tgatomic/DirtyDawg/Dokument/Funktioner.odt

Funktioner

1284P – Linkuras mätare

Funktionsnamn | Beskrivning
System_Init | Ska inititera portarna, watchdog, ADC och sedan kalla funktioner BT_Init, ECG_Init, UART_Init, LIS3DH_Init.
BT_Init | Startar BT121, sätter baudrate, samt initierar den i CLASSIC läge och gör den detekteringsbar och redo att parkopplas.
UART_Init | Sätter baudraten för kommunikation mellan MCU och BT121 samt sätter register för UDR1 och UDR0 (Som är för skicka och ta emot data)
LIS3DH_Init | Intitierar accelerometer
No_Connection | Väntar här till det att bilen har kopplat upp sig till BT121 - modulen
Connected | Skickar accelerometer- och pulsdata till bilen och tar emot distansdata från bilen och skickar det via UART till ATMega8 samt registrerar eventuella knapptryck.

ATMega8-16PU – LCD MCU

Funktionsnamn | Beskrivning
System_Init | Initiera portarna, watchdog, knappar samt UART och eller I2C.
LCD_Init | Skriver ut ett ”Booting” meddelande på skärmen vid power on
Button_Press | Registrerar knapptryck och skickar till 1284p
Dist_Print | Tar emot distansdata från 1284p och skriver ut på LCD

Mega328p – Master bil

Funktionsnamn | Beskrivning
System_Init | Ska inititera portarna, watchdog, ADC och sedan kalla funktioner BT_Init, UART_Init och I2C_Init. Sätter ljusnivåer.
UART_Init | Initierar UART
BT_Init | Intitierar och sätter baudrate för BT
I2C_Init | Intitierar MCU som master och registrerar adressen för ATTiny85
BT_Connect | Väntar på att BT121 blir tillgänglig och kopplar upp när den är tillgänglig
Connected | Läser data från slave i I2C bussen och skickar det till BT121. Läser data från BT121 och kör enligt datan. Går tillbaka till BT_Connect vid förlorad kontakt med BT121
INT_Crash | Stannar bilen om vi får en interrupt från ATTiny85.
Lowrider_Mode | Startar lowrider mode...
Sense_Light | Tänder lamporna på bilen om det är mörkt.

ATTiny85– Slave bil

Funktionsnamn | Beskrivning
System_Init | Ska initiera portarna, watchdog, ADC och sedan kalla funktionen I2C_Init.
IR_Init | Kollar så att IR lamporna och sensorerna är igång genom att kolla sensorinput
I2C_Init | Initierar I2C som slave
INT_Crash | Skickar en interrupt till Mega328P om objekt är för nära
Send_Dist | Skickar distansdata genom I2C
