tgatomic/DirtyDawg/Dokument/Kravlista.odt

Uppgift

Göra en bil som kan detektera avstånd till objekt och skicka den datan vidare till vår kontrollenhet. Genom att få distans till objekt hoppas vi kunna köra bilen utan att vara i samma rum. Bilens hastighet styras av pulsen och styrningen genom vinkeln på kontrollen.

Kravlista för bilen

Index | Historik | Uppgift | Prio
1 | Orginal | Bilen ska ha två MCUs. En som tar hand om sensorer och en som sköter motor och BT-kommunikation | 1
2 | Orginal | Bilen ska ha en IR-sensor som mäter avstånd till objekt. | 1
3 | Orginal | IR Sensorn ska styras med en mikrokontroller och skicka data via I2C bussen till Master. | 1
4 | Orginal | Bilen ska kunna köra framåt, bakåt, höger och vänster | 1
5 | Orginal | Bilen ska kunna skicka distansdata till vår kontroll | 1
6 | Orginal | Bilen ska kunna tända röda lampor när den bromsar eller stannar | 2
7 | Orginal | Bilens lampor ska tändas när det blir mörkt | 2
8 | Orginal | De två MCU:erna på bilen ska kommunicera med varandra genom I2C. | 1
9 | Orginal | Bilen ska kunna tända RGB stripes som sitter under bilen | 2
10 | Orginal | Bilen ska kunna bli en ”low rider” | 3
11 | Orginal | Bilen ska kunna ta emot data från kontrollen via bluetooth | 1
12 | Orginal | Bilen ska dras av batterier | 1
13 | Orginal | Vi ska kunna tuta | 2
14 | Orginal | Bilens hastighet ska kunna ändras baserat på användarens puls | 1

Kravlista för handkontroll

Index | Historik | Uppgift | Prio
15 | Orginal | Kontrollen ska kunna läsa puls och lutningen på kontrollen.Det ska sedan via BT till bilen. | 1
16 | Orginal | Distansdata ska skrivas ut på en display | 1
17 | Orginal | Kontrollen ska kunna drivas med batteri | 1
18 | Orginal | Kontrollen ska ha knapp för att kunna slå på och av lampor samt bil | 1
19 | Orginal | Kontrollen ska ha knapp för tuta | 2
20 | Orginal | Bilen ska ha en ”init low rider” knapp | 3
21 | Orginal | Vara bärbar | 1

Ansvarsområden

Linkuras modul (1284p)

Janne

MCU ( Atmega8-16PU) i handkontroll

Andreas

Distanssensor + MCU (ATTINY84) i bil

Yasmine

Master MCU (UNO) i bil

Christoffer
