tgatomic/DirtyDawg/KiCad - wController/NPN Boost.PNG

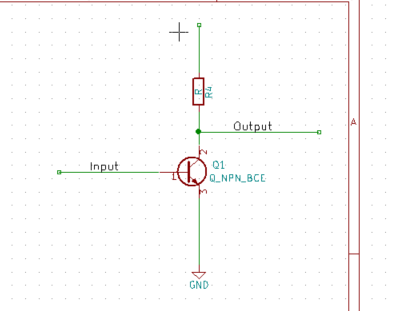
KiCad - wController/NPN Boost.PNG
