tgatomic/DirtyDawg/KiCad - wController/OP.PNG

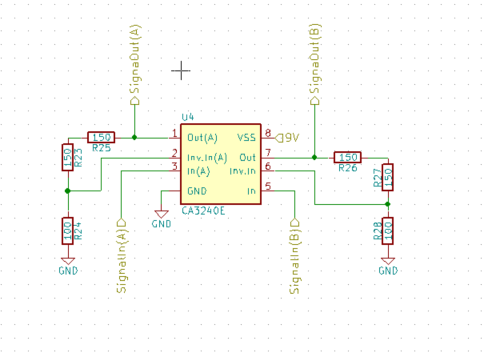
KiCad - wController/OP.PNG
