tgatomic/DirtyDawg/Dokument/Kalkyl.ods

Artikel | Bil/handkontroll | St | Pris | Total | Finns redan | Länk
Linkura mätare | Handkontroll | 1 | 0 |  | X | Linkura bjuder
Strömkälla | Handkontroll | 1 |  | 0
LCD 16x2 | Handkontroll | 2 | 0 | 0 | X | Finns på skolan
BlueSmirf | Bil | 1 | 0 | 0 | X | Finns på skolan
Atmega8-16PU | Handkontroll | 1 | 31 | 31 |  | http://www.electrokit.com/atmega328pu.49179
Strömbrytare | Handkontroll | 1 |  | 20 |  | http://www.kjell.com/se/sortiment/el-verktyg/elektronik/rc-tillbehor/tillbehor-servo-mottagare/1-polig-strombrytare-till-till-100-ma-p67396
Strömbrytare | Handkontroll | 2 | 0 | 24 | X | http://www.kjell.com/se/sortiment/el-verktyg/elektronik/elektromekanik/strombrytare/tryckstrombrytare/tryckstrombrytare-fran-(till)-bla-p36023
Mega328P | Bil | 1 | 39 | 39 |  | http://www.lawicel-shop.se/prod/Mega328P-ArduinoGenuino-UNO-BL_787537/Kretsar_8899/SWE/SEK
ATTiny84 | Bil | 1 | 34 | 34 | X | http://www.lawicel-shop.se/prod/Atmel-AVR-Tiny84---DIP14_977240/Kretsar_8899/SWE/SEK
IR emitter | Bil | 1 | 20 | 20 |  | http://www.kjell.com/se/sortiment/el-verktyg/elektronik/optokomponenter/ir-dioder-fototransistorer/ir-dioder-5-mm-10-pack-p89281
IR reciever | Bil | 4 | 15 | 60 |  | http://www.kjell.com/se/sortiment/el-verktyg/elektronik/optokomponenter/ir-dioder-fototransistorer/fototransistor-5-mm-p90042
Diod | Bil | 4 | 0 | 0 | X | Finns på skolan
H-brygga | Bil | 1 | 21 | 21 | X | http://www.electrokit.com/sn754410ne.49232?sort=price_asc
Strömbrytare | Handkontroll | 1 |  | 20 |  | http://www.kjell.com/se/sortiment/el-verktyg/elektronik/rc-tillbehor/tillbehor-servo-mottagare/1-polig-strombrytare-till-till-100-ma-p67396
RGB | Bil | 1 | 75 | 75 |  | https://www.m.nu/neopixel-stick-ws2812-5050-with-integrated-drivers-p-1081.html
Programmerare | Övrigt | 1 | 129 | 129 |  | http://www.lawicel-shop.se/prod/Pololu-USB-AVR-Programmer-v2_1089820/Pololu_55653/SWE/SEK
Experimentkort | Övrgt | 1 | 59 | 59 |  | http://www.kjell.com/se/sortiment/el-verktyg/elektronik/monsterkort/experimentkort/experimentkort-fr4-100x160-mm-3-lankar-p89417
 |  |  |  | 473 | Med | programerare
 |  |  |  | 344 | Utan | Programerare
