tgatomic/DirtyDawg/Dokument/Testplan.odt

Testplan

Bilen

Index | Testförfarande | Testad
2 | Vi placerar ett objekt på 30 cm och 60 cm och verifierar att vi får rätt distans utskrivet t.ex. genom UART till dator
3 | Vi placerar ett objekt på valfritt avstånd och säkerställer att distansen skickas till master MCU
4 | Vi skriver kod som automatiskt kör en test som ska göra att bilen först kör fram, sen bakåt, höger fram och vänster fram
5 | Vi sätter Master MCU att skicka förangivna värden över BT till vår handkontroll och verifierar att det är samma värden vi tar emot.
6 | Vi skriver en kodsnutt som kör bilen framåt och sedan backar och verifierar att den röda lampan lyser samt att den röda lampan lyser när bilen står stilla
7 | Vi sätter bilen i ett mörkt rum och verifierar att lamporna tänds
8 | Vi testar att skicka en förangiven data från slave till master och verifierar att det är samma data som vi tar emot
9 | Vi skriver en liten kod som tänder RGB lampan
10 | Vi skriver en liten kod som kan sätta bilen i ”low rider”-mode och kollar så att det fungerar
11 | Vi skickar förangiven data från kontrollen till bilen och verifierar att vi får samma till master MCU
12 | Vi låter bilen vara igång en liten stund med batterier och dubbelkollar så att det inte tar slut direkt
13 | Vi gör en kod som slår igång tutan och lyssnar noga
14 | Vi skriver en kod som simulerar puls på Master MCU och kollar om motorns hastighet ändras

Kontrollen

Index | Testförfarande | Testad
15.1 | Vi gör en kod som känner efter puls och kollar det via UART. Vi gör samma med accelerometern
15.2 | När 15.1 är klar, skickar vi datan till MCU Master i bilen och verifierar att vi tagit emot samma data
16.1 | Vi gör en kod som simulerar att vi tagit emot distansdata och skriver ut på LCD displayen
16.2 | När 16.2 är avklarad, testar vi att ta emot distansdata från bilen och verifierar att det är rätt data som tagits emot
17 | Vi kontrollerar att kontrollen kan drivas med ett batteri i minst 5 minuter
18 | Vi kontrollerar att vi kan tända och släcka lamporna med knappar alternativt en snutt kod
