tgatomic/DirtyDawg/(list of files, drawings)

Other design files:
KiCad - wController/Project.dsn
KiCad/Project2.dsn
KiCad/Project3.dsn
KiCad/Project4.dsn
KiCad/Project5.dsn
KiCad/Project6.dsn
KiCad/Project7.dsn
KiCad/Project8.dsn
KiCad/Project9.dsn
KiCad/Project10.dsn
KiCad/Project11.dsn
KiCad/Project.dsn
