tgatomic/DirtyDawg/KiCad/Project.kicad_pcb

## KiCad design KiCad/Project.kicad_pcb (2016-06-13)

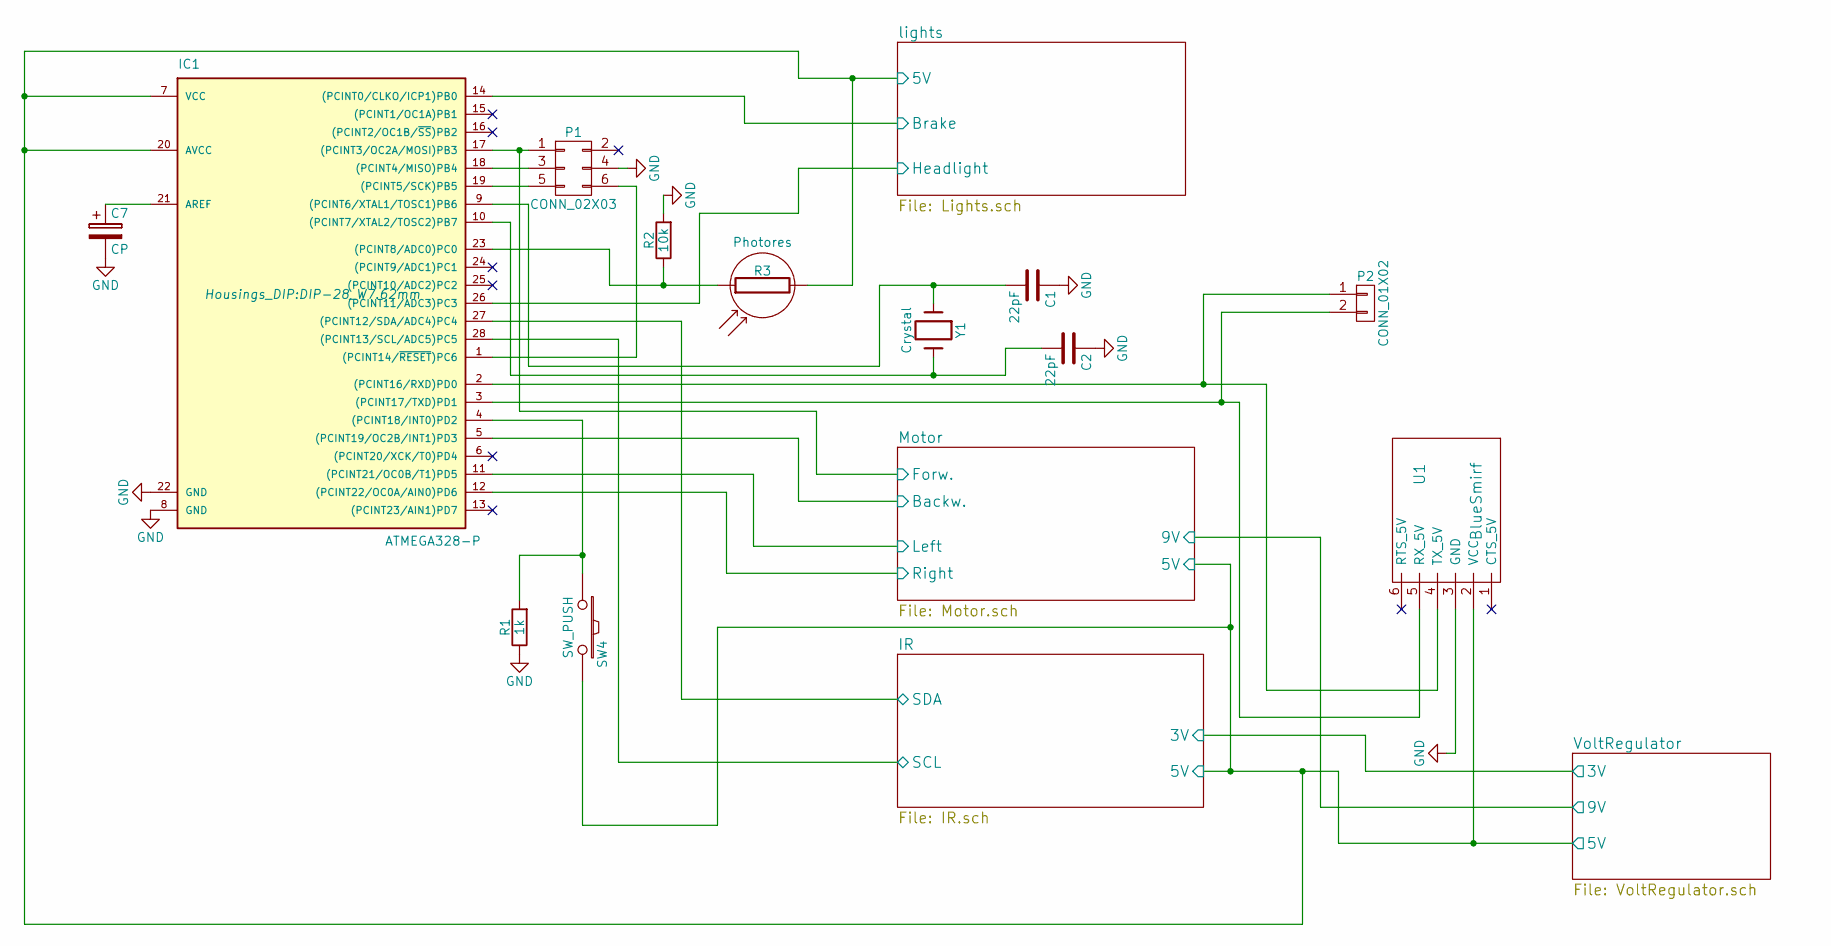
[picture p3: schematic Project.sch]

Parts:
C1, C2: 22pF; C_Disc_D3_P2.5
C7: CP; C_Radial_D5_L6_P2.5
IC1: ATMEGA328-P; DIP-28_W7.62mm
P1: CONN_02X03; Pin_Header_Straight_2x03
P2: CONN_01X02; Pin_Header_Straight_1x02
R1: 1k; Resistor_Vertical_RM5mm
R2: 10k; Resistor_Vertical_RM5mm
R3: Photores; SolderWirePad1mmmodified
SW4: SW_PUSH; SolderWirePad1mmmodified
U1: BlueSmirf; Pin_Header_Straight_1x06_Pitch2.00mm
Y1: Crystal; Crystal_HC52-U_Vertical

Connections:
/IR/5V: IC1.7 (VCC), IC1.20 (AVCC), R3.2, SW4.2, U1.2 (VCC); also elsewhere on the board
/IR/SCL: IC1.28 ((PCINT13/SCL/ADC5)PC5); also elsewhere on the board
/IR/SDA: IC1.27 ((PCINT12/SDA/ADC4)PC4); also elsewhere on the board
/Motor/Backw.: IC1.5 ((PCINT19/OC2B/INT1)PD3); also elsewhere on the board
/Motor/Forw.: IC1.17 ((PCINT3/OC2A/MOSI)PB3), P1.1; also elsewhere on the board
/Motor/Left: IC1.11 ((PCINT21/OC0B/T1)PD5); also elsewhere on the board
/Motor/Right: IC1.12 ((PCINT22/OC0A/AIN0)PD6); also elsewhere on the board
/lights/Brake: IC1.14 ((PCINT0/CLKO/ICP1)PB0); also elsewhere on the board
/lights/Headlight: IC1.26 ((PCINT11/ADC3)PC3); also elsewhere on the board
GND: C1.1, C2.1, C7.2, IC1.8 (GND), IC1.22 (GND), P1.4, R1.1, R2.2, U1.3 (GND); also elsewhere on the board
unnamed: C1.2, IC1.9 ((PCINT6/XTAL1/TOSC1)PB6), Y1.1
unnamed: C2.2, IC1.10 ((PCINT7/XTAL2/TOSC2)PB7), Y1.2
unnamed: C7.1, IC1.21 (AREF)
unnamed: IC1.1 ((PCINT14/~RESET~)PC6), P1.6
unnamed: IC1.2 ((PCINT16/RXD)PD0), P2.1, U1.4 (TX_5V)
unnamed: IC1.3 ((PCINT17/TXD)PD1), P2.2, U1.5 (RX_5V)
unnamed: IC1.4 ((PCINT18/INT0)PD2), R1.2, SW4.1
unnamed: IC1.18 ((PCINT4/MISO)PB4), P1.3
unnamed: IC1.19 ((PCINT5/SCK)PB5), P1.5
unnamed: IC1.23 ((PCINT8/ADC0)PC0), R2.1, R3.1

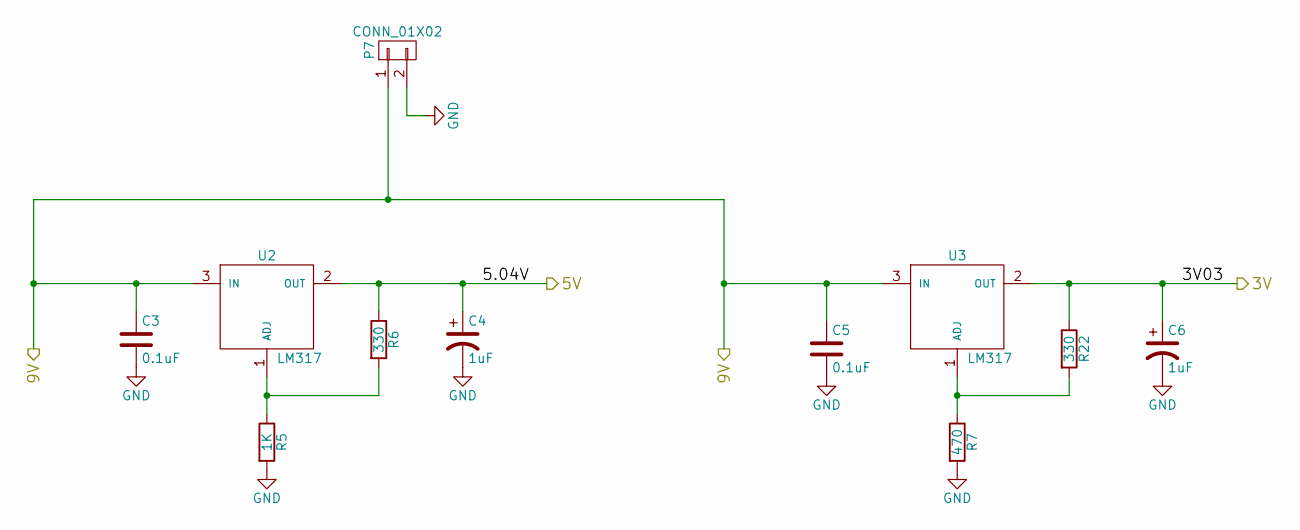
[picture p4: schematic VoltRegulator.sch]

Parts:
C3, C5: 0.1uF; C_Disc_D3_P2.5
C4, C6: 1uF; C_Radial_D5_L6_P2.5
P7: CONN_01X02; Pin_Header_Straight_1x02
R5: 1K; Resistor_Vertical_RM5mm
R6, R22: 330; Resistor_Vertical_RM5mm
R7: 470; Resistor_Vertical_RM5mm
U2, U3: LM317; TO-220_Neutral123_Vertical

Connections:
/IR/3V: C6.1, R22.1, U3.2 (OUT); also elsewhere on the board
/IR/5V: C4.1, R6.1, U2.2 (OUT); also elsewhere on the board
/Motor/9V: C3.1, C5.1, P7.1, U2.3 (IN), U3.3 (IN); also elsewhere on the board
GND: C3.2, C4.2, C5.2, C6.2, P7.2, R5.2, R7.2; also elsewhere on the board
unnamed: R5.1, R6.2, U2.1 (ADJ)
unnamed: R7.1, R22.2, U3.1 (ADJ)

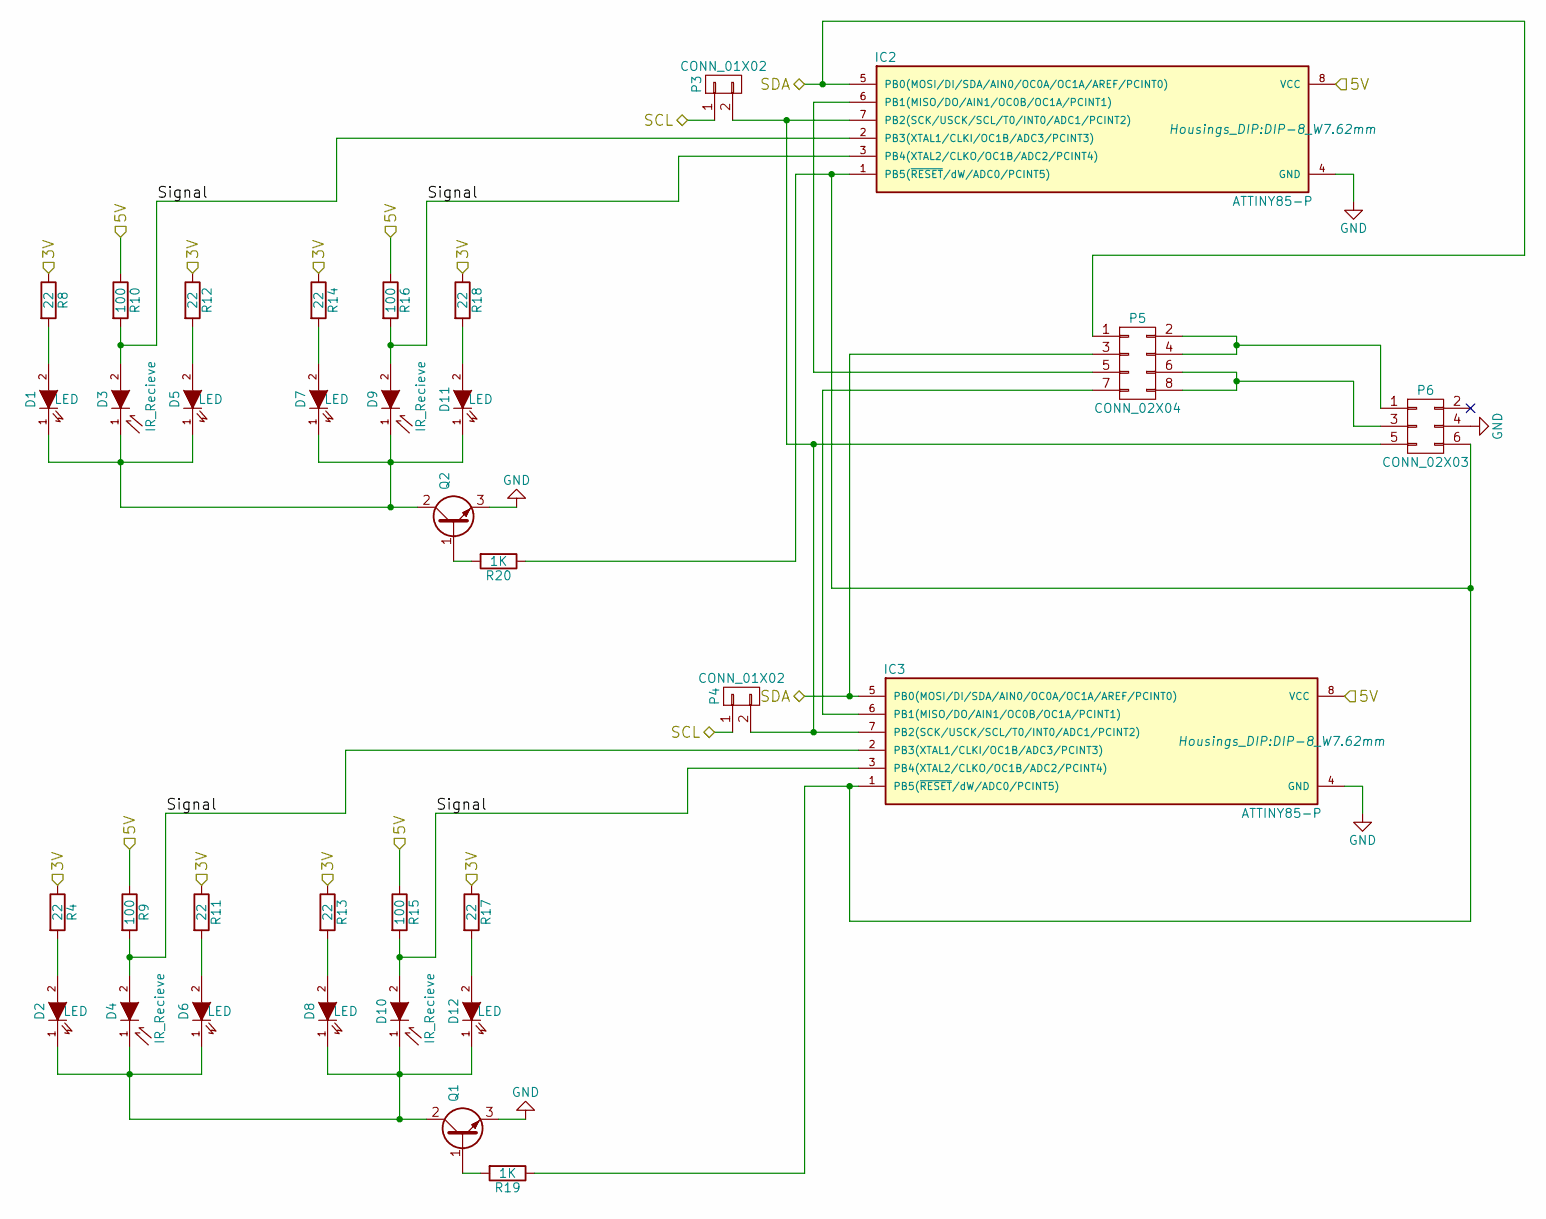
[picture p5: schematic IR.sch]

Parts:
D1, D2, D5, D6, D7, D8, D11, D12: LED; SolderWirePad1mmmodified
D3, D4, D9, D10: IR_Recieve; SolderWirePad1mmmodified
IC2, IC3: ATTINY85-P; DIP-8_W7.62mm
P3, P4: CONN_01X02; Pin_Header_Straight_2x01
P5: CONN_02X04; Pin_Header_Straight_2x04
P6: CONN_02X03; Pin_Header_Straight_2x03
Q1, Q2: Q_NPN_BCE; TO-92_Inline_Narrow_Oval
R4, R8, R11, R12, R13, R14, R17, R18: 22; Resistor_Vertical_RM5mm
R9, R10, R15, R16: 100; Resistor_Vertical_RM5mm
R19, R20: 1K; Resistor_Vertical_RM5mm

Connections:
/IR/3V: R4.1, R8.1, R11.1, R12.1, R13.1, R14.1, R17.1, R18.1; also elsewhere on the board
/IR/5V: IC2.8 (VCC), IC3.8 (VCC), R9.1, R10.1, R15.1, R16.1; also elsewhere on the board
/IR/SCL: P3.1, P4.1; also elsewhere on the board
/IR/SDA: IC2.5 (PB0(MOSI/DI/SDA/AIN0/OC0A/OC1A/AREF/PCI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), IC3.5 (PB0(MOSI/DI/SDA/AIN0/OC0A/OC1A/AREF/PCI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), P5.1, P5.3; also elsewhere on the board
/IR/Signal: D3.2 (A), D4.2 (A), D9.2 (A), D10.2 (A), IC2.2 (PB3(XTAL1/CLKI/OC1B/ADC3/PCINT3)), IC2.3 (PB4(XTAL2/CLKO/OC1B/ADC2/PCINT4)), IC3.2 (PB3(XTAL1/CLKI/OC1B/ADC3/PCINT3)), IC3.3 (PB4(XTAL2/CLKO/OC1B/ADC2/PCINT4)), R9.2, R10.2, R15.2, R16.2
GND: IC2.4 (GND), IC3.4 (GND), P6.4, Q1.3 (E), Q2.3 (E); also elsewhere on the board
unnamed: D1.1 (K), D3.1 (K), D5.1 (K), D7.1 (K), D9.1 (K), D11.1 (K), Q2.2 (C)
unnamed: D1.2 (A), R8.2
unnamed: D2.2 (A), R4.2
unnamed: D5.2 (A), R12.2
unnamed: D6.2 (A), R11.2
unnamed: D7.2 (A), R14.2
unnamed: D8.2 (A), R13.2
unnamed: D2.1 (K), D4.1 (K), D6.1 (K), D8.1 (K), D10.1 (K), D12.1 (K), Q1.2 (C)
unnamed: D11.2 (A), R18.2
unnamed: D12.2 (A), R17.2
unnamed: IC2.1 (PB5(~RESET~/dW/ADC0/PCINT5)), IC3.1 (PB5(~RESET~/dW/ADC0/PCINT5)), P6.6, R19.1, R20.1
unnamed: IC2.6 (PB1(MISO/DO/AIN1/OC0B/OC1A/PCINT1)), P5.5
unnamed: IC2.7 (PB2(SCK/USCK/SCL/T0/INT0/ADC1/PCINT2)), IC3.7 (PB2(SCK/USCK/SCL/T0/INT0/ADC1/PCINT2)), P3.2, P4.2, P6.5
unnamed: IC3.6 (PB1(MISO/DO/AIN1/OC0B/OC1A/PCINT1)), P5.7
unnamed: P5.2, P5.4, P6.1
unnamed: P5.6, P5.8, P6.3
unnamed: Q1.1 (B), R19.2
unnamed: Q2.1 (B), R20.2

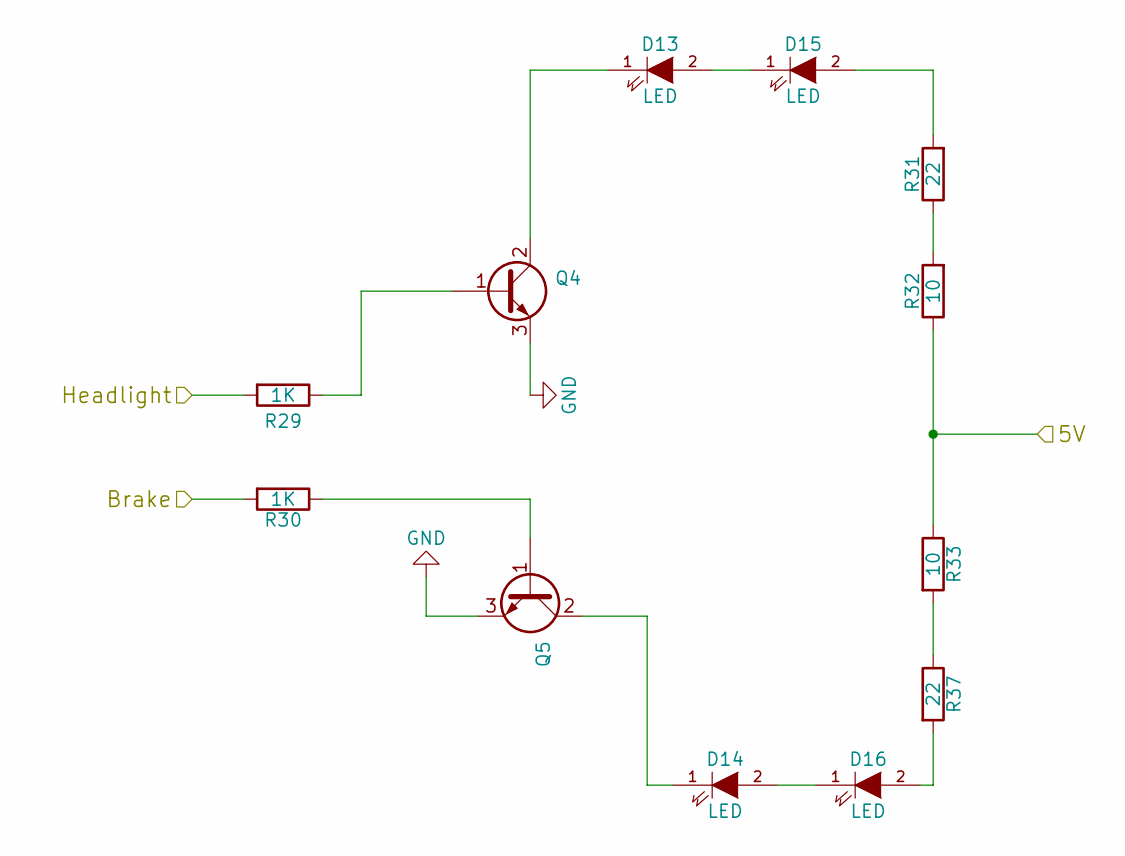
[picture p6: schematic Lights.sch]

Parts:
D13, D14, D15, D16: LED; SolderWirePad1mmmodified
Q4: Q_NPN_BCE; TO-92_Inline_Narrow_Oval
Q5: NPN; TO-92_Inline_Narrow_Oval
R29, R30: 1K; Resistor_Vertical_RM5mm
R31, R37: 22; Resistor_Vertical_RM5mm
R32, R33: 10; Resistor_Vertical_RM5mm

Connections:
/IR/5V: R32.1, R33.1; also elsewhere on the board
/lights/Brake: R30.2; also elsewhere on the board
/lights/Headlight: R29.2; also elsewhere on the board
GND: Q4.3 (E), Q5.3 (E); also elsewhere on the board
unnamed: D13.1 (K), Q4.2 (C)
unnamed: D13.2 (A), D15.1 (K)
unnamed: D14.1 (K), Q5.2 (C)
unnamed: D14.2 (A), D16.1 (K)
unnamed: D15.2 (A), R31.2
unnamed: D16.2 (A), R37.2
unnamed: Q4.1 (B), R29.1
unnamed: Q5.1 (B), R30.1
unnamed: R31.1, R32.2
unnamed: R33.2, R37.1

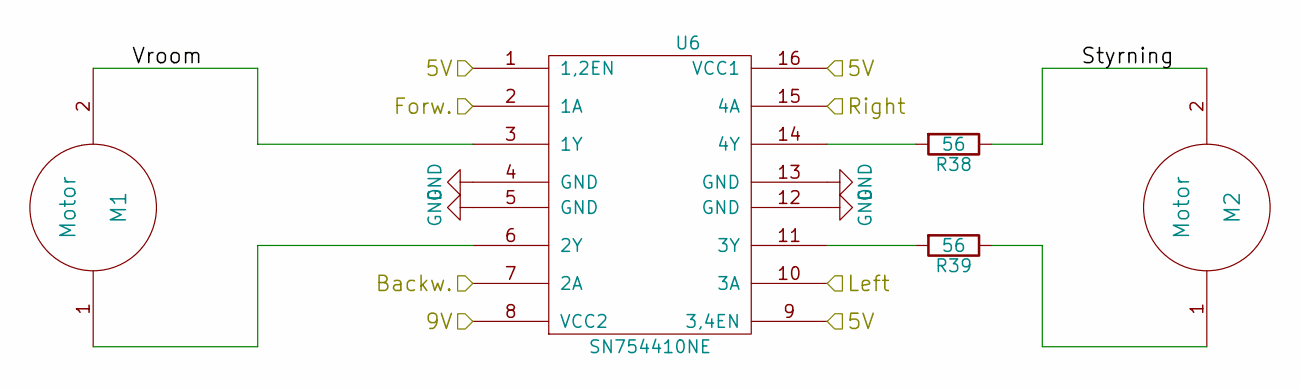
[picture p7: schematic Motor.sch]

Parts:
M1, M2: Motor; SolderWirePad1mmmodified
R38, R39: 56; Resistor_Vertical_RM5mm
U6: SN754410NE; DIP-16_W7.62mm_LongPads

Connections:
/IR/5V: U6.1 (1,2EN), U6.9 (3,4EN), U6.16 (VCC1); also elsewhere on the board
/Motor/9V: U6.8 (VCC2); also elsewhere on the board
/Motor/Backw.: U6.7 (2A); also elsewhere on the board
/Motor/Forw.: U6.2 (1A); also elsewhere on the board
/Motor/Left: U6.10 (3A); also elsewhere on the board
/Motor/Right: U6.15 (4A); also elsewhere on the board
/Motor/Styrning: M2.2, R38.1
/Motor/Vroom: M1.2, U6.3 (1Y)
GND: U6.4 (GND), U6.5 (GND), U6.12 (GND), U6.13 (GND); also elsewhere on the board
unnamed: M1.1, U6.6 (2Y)
unnamed: M2.1, R39.1
unnamed: R38.2, U6.14 (4Y)
unnamed: R39.2, U6.11 (3Y)

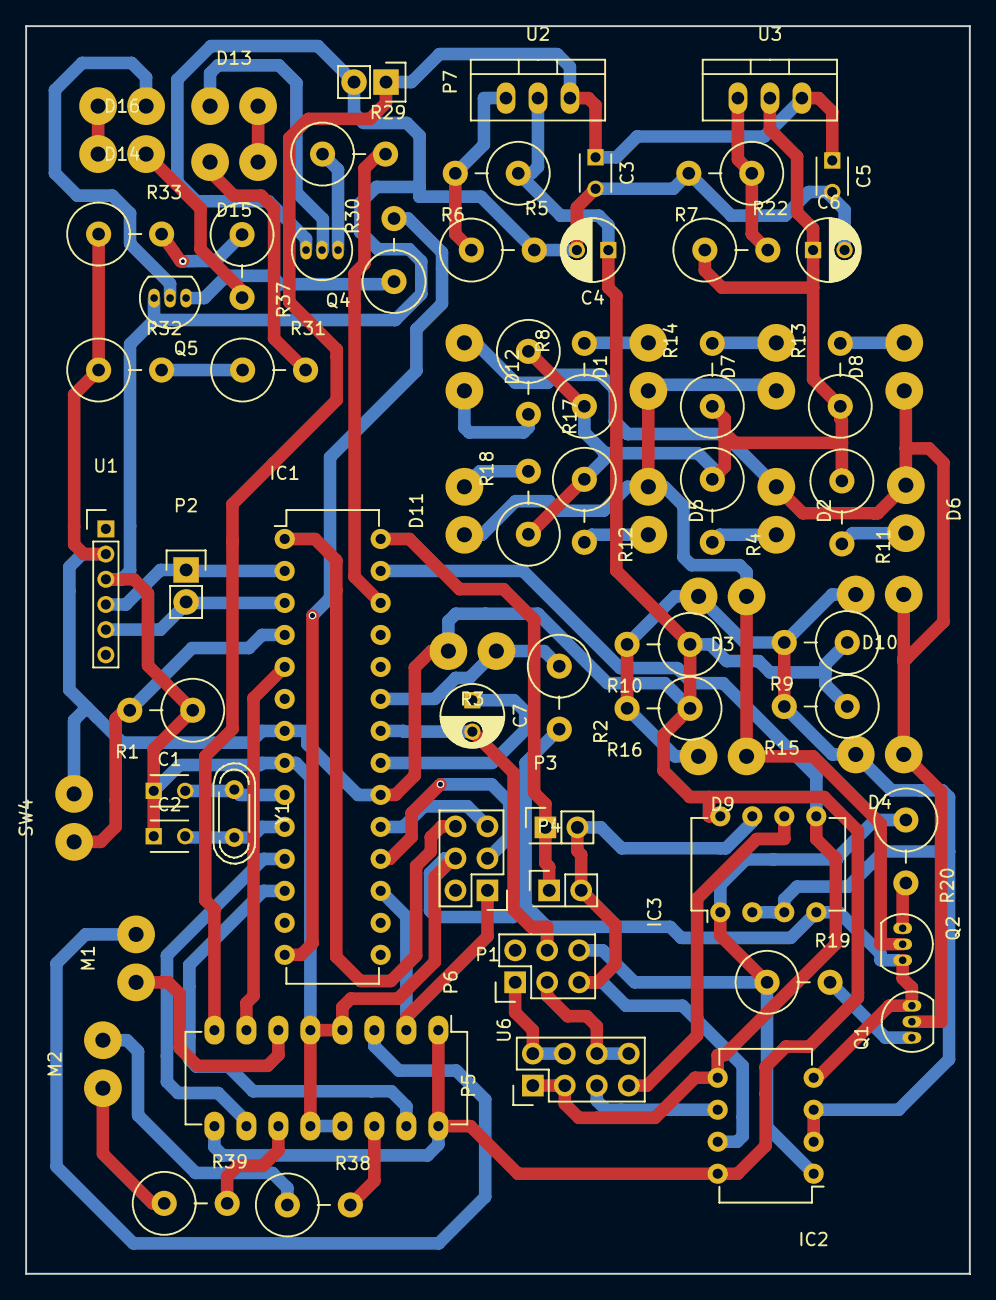
[picture p8: board KiCad/Project.kicad_pcb from above]

Board: 2 copper layers, 74.9 x 99.1 mm, 74 parts (0 on the bottom side), 59 nets.
