tgatomic/DirtyDawg/KiCad - wController/Project.kicad_pcb

## KiCad design KiCad - wController/Project.kicad_pcb (2016-05-26)

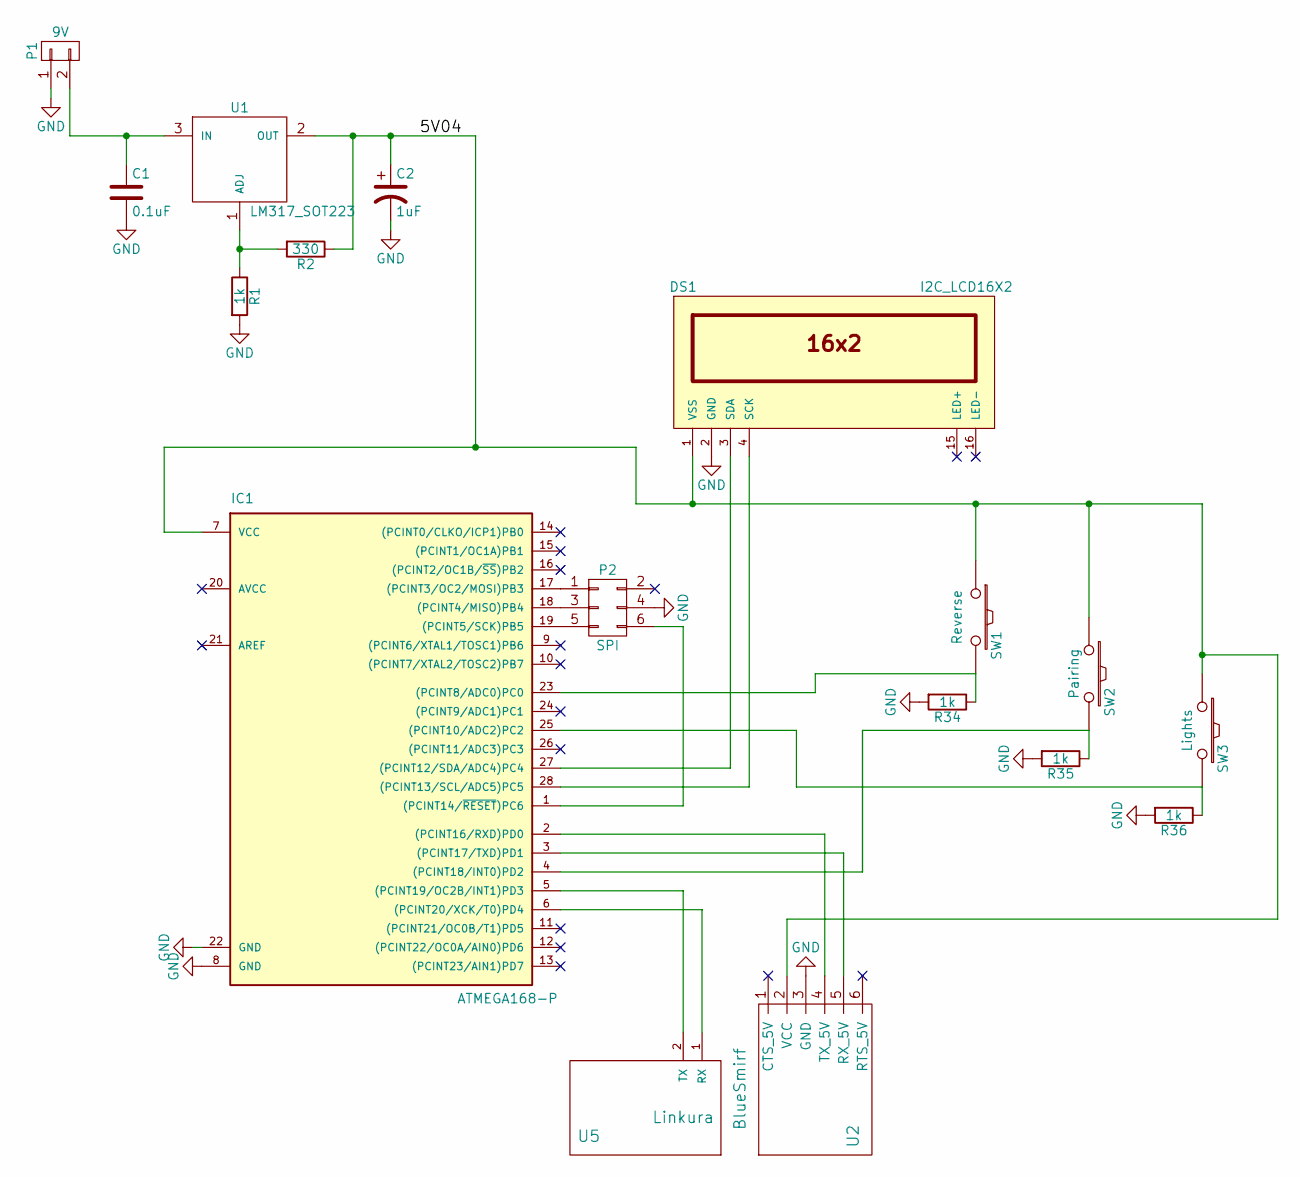
[picture p9: schematic Controller.sch]

Parts:
C1: 0.1uF; C_Disc_D6_P5
C2: 1uF; C_Radial_D5_L11_P2
DS1: I2C_LCD16X2; Pin_Header_Straight_1x04
IC1: ATMEGA168-P; DIP-28_W7.62mm
P1: 9V; SolderWirePad1mmmodified
P2: SPI; Pin_Header_Straight_2x03
R1, R34, R35, R36: 1k; Resistor_Vertical_RM5mm
R2: 330; Resistor_Vertical_RM5mm
SW1: Reverse; SolderWirePad1mmmodified
SW2: Pairing; SolderWirePad1mmmodified
SW3: Lights; SolderWirePad1mmmodified
U1: LM317_SOT223; TO-220_Neutral123_Vertical
U2: BlueSmirf; Pin_Header_Straight_1x06
U5: Linkura; Pin_Header_Straight_1x02

Connections:
/Controller/5V04: C2.1, DS1.1 (VSS), IC1.7 (VCC), R2.1, SW1.1, SW2.1, SW3.1, U1.2 (OUT), U2.2 (VCC)
GND: C1.2, C2.2, DS1.2 (GND), IC1.8 (GND), IC1.22 (GND), P1.1, P2.4, R1.2, R34.2, R35.2, R36.2, U2.3 (GND)
unnamed: C1.1, P1.2, U1.3 (IN)
unnamed: DS1.3 (SDA), IC1.27 ((PCINT12/SDA/ADC4)PC4)
unnamed: DS1.4 (SCK), IC1.28 ((PCINT13/SCL/ADC5)PC5)
unnamed: IC1.1 ((PCINT14/~RESET~)PC6), P2.6
unnamed: IC1.2 ((PCINT16/RXD)PD0), U2.4 (TX_5V)
unnamed: IC1.3 ((PCINT17/TXD)PD1), U2.5 (RX_5V)
unnamed: IC1.4 ((PCINT18/INT0)PD2), R35.1, SW2.2
unnamed: IC1.5 ((PCINT19/OC2B/INT1)PD3), U5.2 (TX)
unnamed: IC1.6 ((PCINT20/XCK/T0)PD4), U5.1 (RX)
unnamed: IC1.17 ((PCINT3/OC2/MOSI)PB3), P2.1
unnamed: IC1.18 ((PCINT4/MISO)PB4), P2.3
unnamed: IC1.19 ((PCINT5/SCK)PB5), P2.5
unnamed: IC1.23 ((PCINT8/ADC0)PC0), R34.1, SW1.2
unnamed: IC1.25 ((PCINT10/ADC2)PC2), R36.1, SW3.2
unnamed: R1.1, R2.2, U1.1 (ADJ)

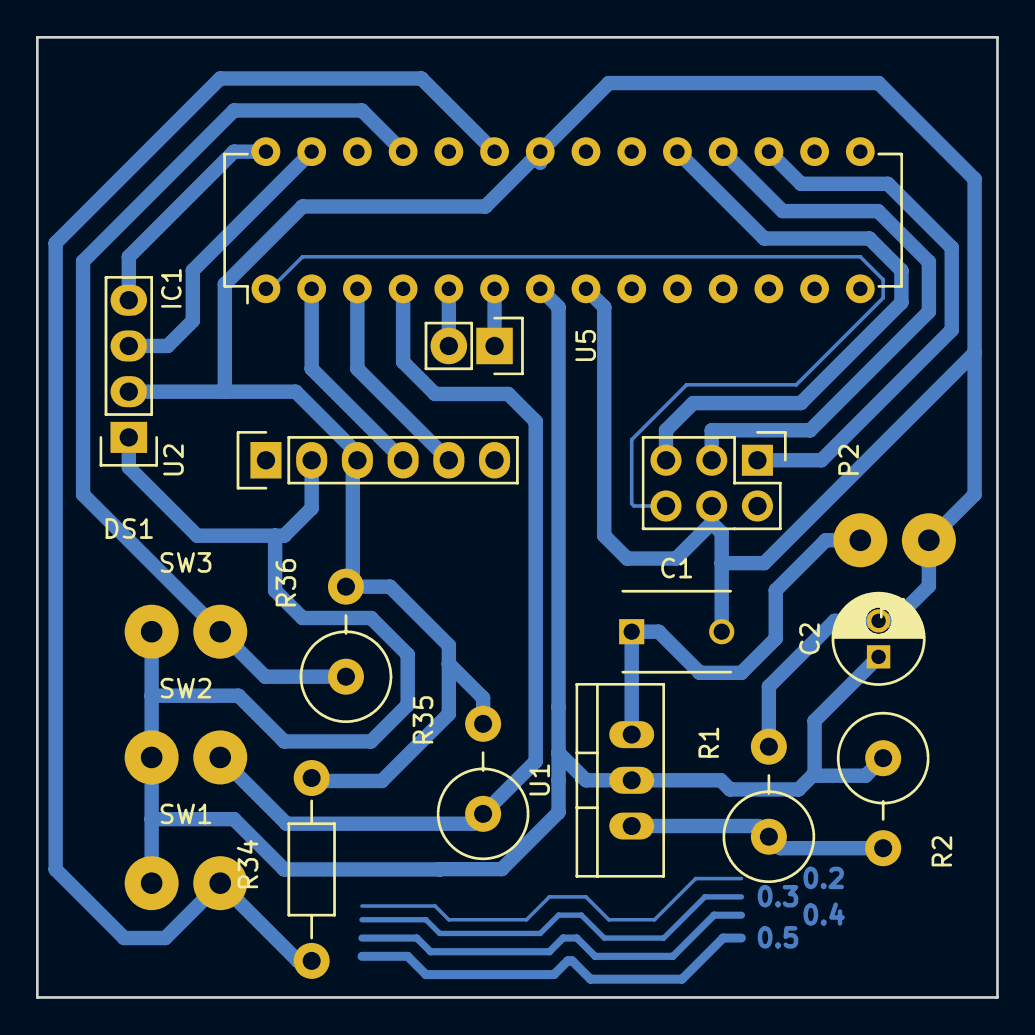
[picture p10: board KiCad - wController/Project.kicad_pcb from above]

Board: 2 copper layers, 53.3 x 53.3 mm, 17 parts (0 on the bottom side), 17 nets.
