tgatomic/DirtyDawg/Code/Dirty_Dawg_Master/Dirty_Dawg_Master/Dirty_Dawg_Master/PWM.c

/*
 * PWM.c
 *
 * Created: 2016-04-28 09:53:56
 *  Author: Atomic
 */ 
#define F_CPU 8000000UL

#include <avr/io.h>
#include <util/delay.h>
#include "PWM.h"
#include "functions.h"
#include "Bluetooth.h"
#include "Error_Codes.h"

void PWM_Init(void){
	
	/*The PRTIM0 bit in ”Minimizing Power Consumption on page 42 must be written to zero to enable
	Timer/Counter0 module.*/
	PRR &= (0<<PRTIM0); 
	
	DDRD = (1<<PORTD5) | (1<<PORTD6) | (1<<PORTD3);
	DDRB |= (1<<PORTB3);
	
	//, TCNT0 for accessing Timer/Counter0 counter value and so on.
	
	//A lower case n replaces the timer/counter number
	
	//Max 255, Min 0
	
	/************************************************************************/
	/*					Settings for both channels						    */
	/* Timer Clock = CPU Clock without prescaling							*/
	/* Mode = Fast PWM														*/
	/* PWM Output = Non inverted                                            */                         
	/************************************************************************/
	//TCCR2A = (1<<WGM21) | (1<<WGM20) | (1<<COM2B1);
	//TCCR2B = (1<<CS20); //Sets it to non inverted
	
	//WGM = Fast PWM
	//Fast pwm = Non inverted. only com0A1 set
	//no prescaler
	TCCR0A = (1<<WGM00) | (1<<WGM01) | (1<<COM0A1) | (1<<COM0B1);
	TCCR0B = (1<<CS00); //Sets it to non inverted
	
	
	
	//
	TCCR2A = (1<<WGM20) | (1<<WGM21) | (1<<COM2A1) | (1<<COM2B1);
	TCCR2B = (1<<CS20); //No prescaler
	
	//Enables the pins = COM0A1 COM1A1
	//TCNT1 use for something???
	
	Stop_Moving();

}

void Stop_Moving(void){
	
	//Stops the car from moving
	PWM_BACKWARD = 0; //OK
	PWM_FORWARD = 0;
	PWM_LEFT = 0; //OK
	PWM_RIGHT = 0;
	
}

void Drive(uint8_t direction, uint8_t speed){
	
	
	//If speed is greater or smaller than the possible value
	if( (speed < 0) | (speed > 255) ) Error(BAD_VAL);
	
	
	switch(direction){
		case F:
			PWM_BACKWARD = 0x00;
			PWM_FORWARD = speed;
			break;
		case B:
			PWM_FORWARD = 0x00;
			PWM_BACKWARD = speed;
			break;
		case L:
			PWM_RIGHT = 0x00;
			PWM_LEFT = speed;
			break;
		case R:
			PWM_LEFT = 0x00;
			PWM_RIGHT = speed;
			break;
	}
	
	
}
