tgatomic/DirtyDawg/(commit log)

2016-04-12 Added the list of items
    [Kalkyl.ods]
2016-04-13 Added documents
    Added Tidsplan, Kravlista, Tidsplan and Kalkyl
    [Kalkyl.ods, Tidsplan.ods]
2016-04-18 Added KiCad Project
    [Project.kicad_pcb, Project.sch]
2016-04-19 Added schematicsdocument
    Only the remote controller left
    [IR.sch, Lights.sch, Project.kicad_pcb, Project.sch, VoltRegulator.sch]
2016-04-25 Added the Hbridge
    The schematics is almost completed with all the values set on resitors
    and all the components should be there. Minor changes is to be expected
    though.
    [Controller.sch, Motor.sch, OpAmp.sch, Project.sch, VoltRegulator.sch, _saved_Motor.sch]
2016-04-25 CHange in motorSchematics
    [Motor.sch]
2016-04-25 Changed values of resistors
    [Motor.sch]
2016-04-28 Added PWM TWI ADC to project
    Added initialization functions for PWM, ADC and TWI so it should work
    now.
2016-05-01 Added tasklist explenation
    [Lights.sch, Motor.sch, OpAmp.sch, Project.sch, VoltRegulator.sch]
2016-05-01 Added anotation and footprints
    [Controller.sch, IR.sch]
2016-05-02 Updated Tidsplan
    [Tidsplan.ods]
2016-05-09 Uppdaterat tidsplanen
    [Tidsplan.ods]
2016-05-11 Fixed PWM init
2016-05-11 Updated the schematics and started with the PCB
    [Controller.sch, IR.sch, Lights.sch, Motor.sch, OpAmp.sch, Project.kicad_pcb, Project.sch, VoltRegulator.sch]
2016-05-11 Added two files to comit
    [Motor.sch]
2016-05-12 Started with the PCB
    [Controller.sch, IR.sch, Lights.sch, Motor.sch, OpAmp.sch, Project.kicad_pcb, Project.sch, VoltRegulator.sch]
2016-05-13 Started to do the routing
    [IR.sch, Lights.sch, Motor.sch, Project.dsn, Project.kicad_pcb, Project.sch, VoltRegulator.sch]
2016-05-15 Started to finalize all but sensor state
2016-05-16 Added smaller footprints
    [IR.sch, Lights.sch, Motor.sch, Project.kicad_pcb, Project.sch, Project2.dsn, VoltRegulator.sch]
2016-05-16 Tested the motorcontroller - working
2016-05-17 Betarelease
    All states are written, interrupt UART is working, all communication is
    working, ADC is working, TWI is working, TWI LCD is working, PWM is
    working. All should be go for testing.
2016-05-17 Release fixes
    Turned on release instead of debug and did some small
    changes/corrections
    [TWI_Master.h, main.c]
2016-05-18 Deleted kicad folder before merge with master
2016-05-18 Revert "Added smaller footprints"
    This reverts commit 0613a684753a289cb87120d105616d3a60c555f9.
    [IR.sch, Lights.sch, Motor.sch, Project.kicad_pcb, Project.sch, Project2.dsn, VoltRegulator.sch]
2016-05-18 Revert "Revert "Added smaller footprints""
    This reverts commit e704f44f413b623022dd61e84b83712d6d051894.
    [IR.sch, Lights.sch, Motor.sch, Project.kicad_pcb, Project.sch, Project2.dsn, VoltRegulator.sch]
2016-05-18 Updated the pcb to smaller size and footprints
    [IR.sch, Kalkyl.ods, Lights.sch, Motor.sch, Project.kicad_pcb, Project.sch, Project10.dsn, Project3.dsn]
2016-05-19 Added code and created PCB for controller
    [Controller.sch, Project.dsn, Project.kicad_pcb, Project.sch]
2016-05-23 Small updates
    [Project.kicad_pcb]
2016-05-23 Changed size of PCB and started with BT communication
    [Project.kicad_pcb, Project11.dsn]
2016-05-26 Updated controller PCB and added pariing mode to BT
    [Project.kicad_pcb, _saved_Project.sch]
2016-05-27 Updated code for BT pairing and modified vias in PCB
    [Project.kicad_pcb]
2016-06-02 Added project for ATTiny85 with support for TWI.
    Also made a function where 328p asks for data in txsendbuffer from
    ATtiny, and prints it on the LCD screen.
2016-06-08 Working ADC!
    [Controller.sch, Project.sch, _saved_Project.sch]
2016-06-13 Working bluetooth command
    [Project.kicad_pcb]
